Rupp-11/Wind-Tunnel/firmware/README.md

# Firmware (C++)

Coloque aqui o código C++ do microcontrolador (ex.: `wind_tunnel.ino`).

- Comunicação serial: **115200 baud**
- Leitura de HX711 (força), anemômetro, NTC; saída PWM do ventilador; display OLED.
