Rupp-11/Wind-Tunnel/analysis/resumo_testes.csv

teste | objeto | area_m2 | pico_forca_N | velocidade_no_pico_kmh | cd_medio
3 | Bugatti Chiron | 0.0015 | 0.052 | 78.2 | 0.0959
3 | Mercedes-Benz G500 | 0.0018 | 0.089 | 70.6 | 0.1623
4 | Bugatti Chiron | 0.0015 | 0.046 | 76.2 | 0.0840
4 | Mercedes-Benz G500 | 0.0018 | 0.082 | 72.1 | 0.1425
5 | Bugatti Chiron | 0.0015 | 0.047 | 74.2 | 0.0950
5 | Mercedes-Benz G500 | 0.0018 | 0.084 | 72.6 | 0.1517
