Rupp-11/Wind-Tunnel/images/resultados/teste_4.png

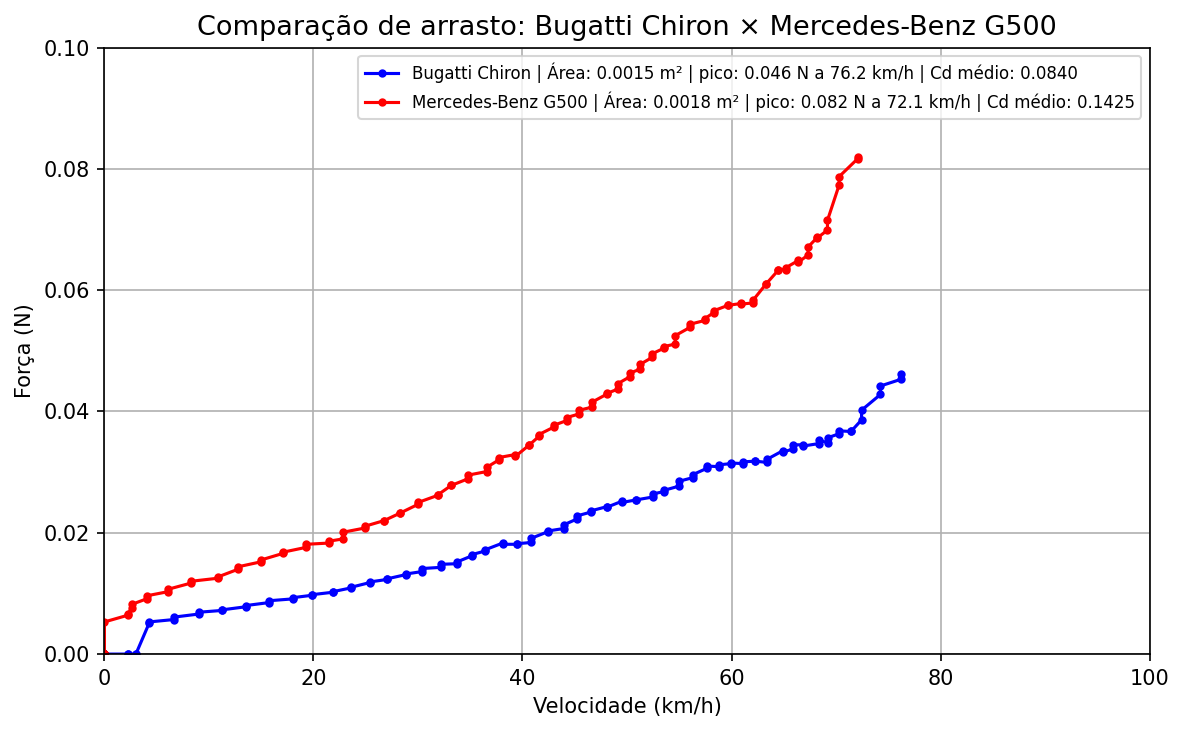
images/resultados/teste_4.png
